monoradio102/ai-lchika/summon/ca_cert.h

#pragma once

// Root CAs for api.openai.com (checked 2026-10-01: leaf <- WE1 <- GTS Root R4).
// GTS Root R1 and GlobalSign Root CA are kept as fallbacks in case the chain changes.
static const char OPENAI_ROOT_CA[] = R"PEM(
-----BEGIN CERTIFICATE-----
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
-----END CERTIFICATE-----
-----BEGIN CERTIFICATE-----
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
bP6MvPJwNQzcmRk13NfIRmPVNnGuV/u3gm3c
-----END CERTIFICATE-----
-----BEGIN CERTIFICATE-----
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
HMUfpIBvFSDJ3gyICh3WZlXi/EjJKSZp4A==
-----END CERTIFICATE-----
)PEM";
